Normansrule/tinytapeout-tinypulse/docs/images/layout.png

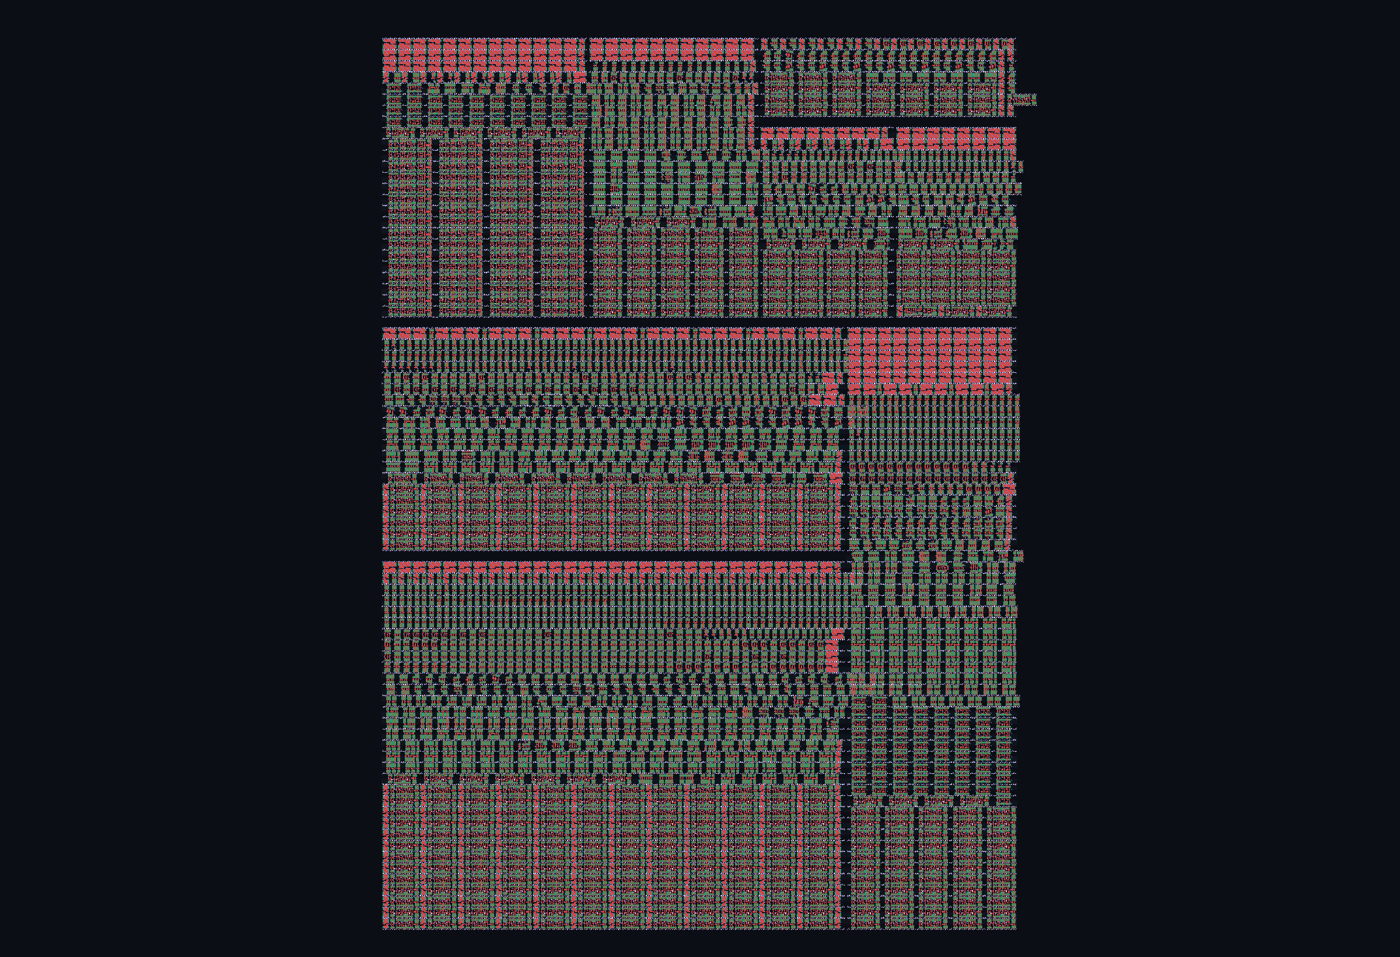
docs/images/layout.png
