Normansrule/tinytapeout-tinypulse/docs/images/layout_zoom.png

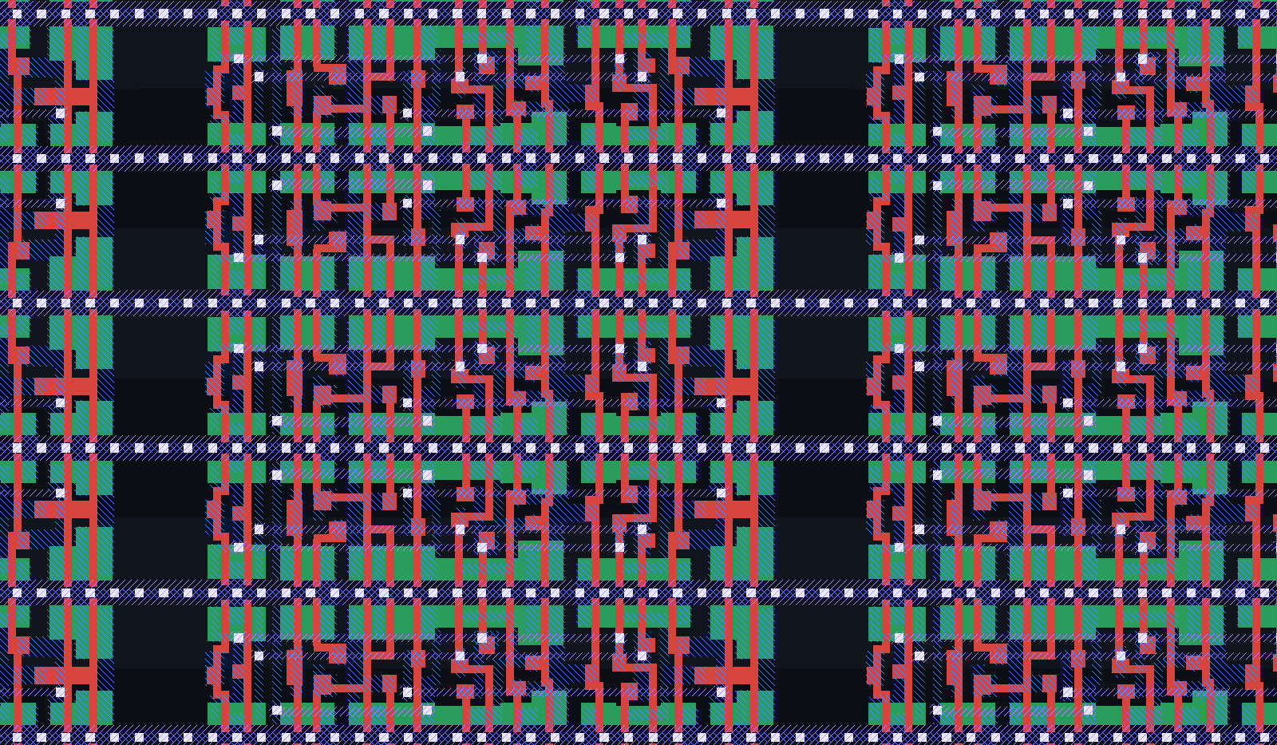
docs/images/layout_zoom.png
